SourishOP/Variable-rate-sprayer/report/figures/chart_spray_time.png

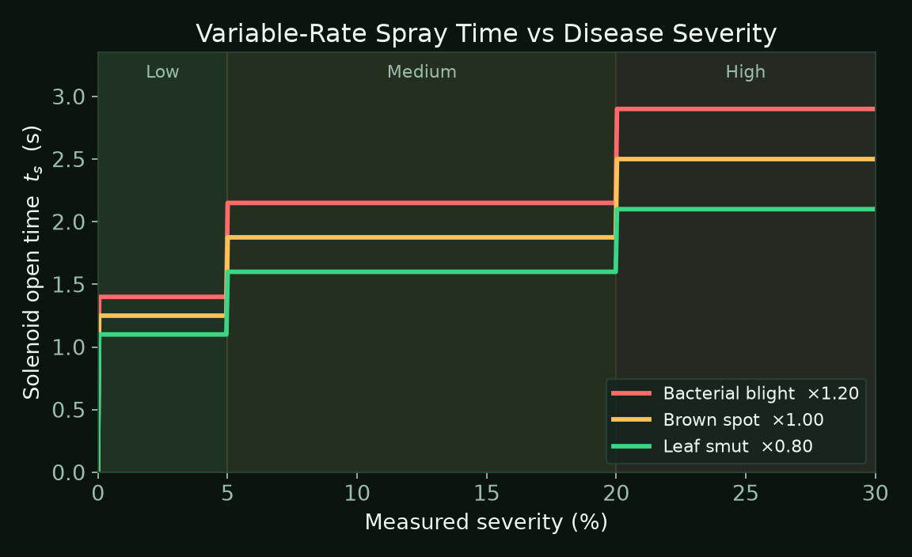
report/figures/chart_spray_time.png
