SourishOP/Variable-rate-sprayer/report/figures/fig_chemical_comparison.png

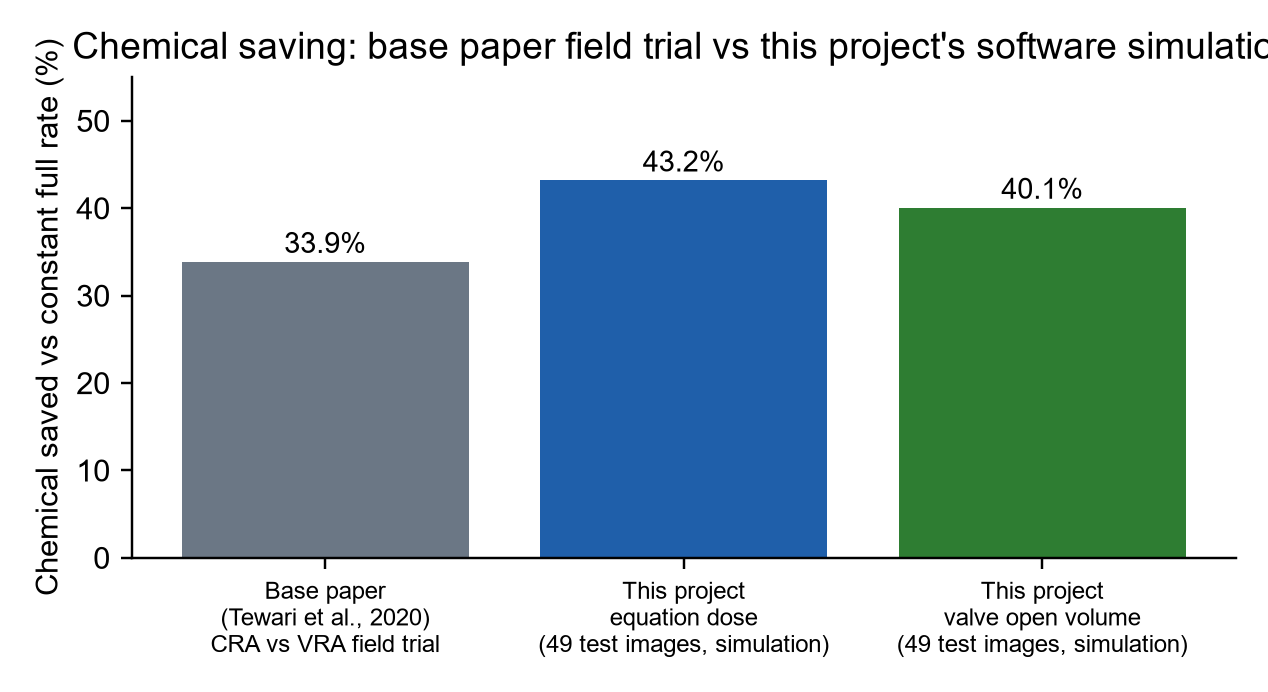
report/figures/fig_chemical_comparison.png
