SourishOP/Variable-rate-sprayer/report/figures/overlays/Bacterial_Blight__Bacterial_Blight_04.png

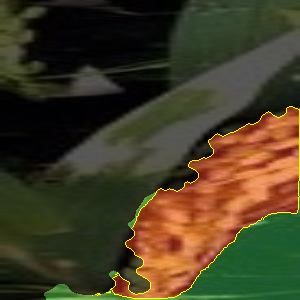
report/figures/overlays/Bacterial_Blight__Bacterial_Blight_04.png
