SourishOP/Variable-rate-sprayer/report/figures/overlays/Bacterial_Blight__Bacterial_Blight_07.png

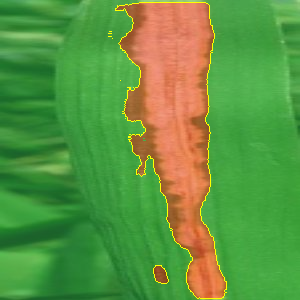
report/figures/overlays/Bacterial_Blight__Bacterial_Blight_07.png
