SourishOP/Variable-rate-sprayer/report/figures/overlays/Brown_Spot__Brown_Spot_06.png

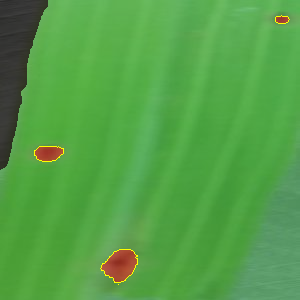
report/figures/overlays/Brown_Spot__Brown_Spot_06.png
