SourishOP/Variable-rate-sprayer/report/figures/overlays/Brown_Spot__Brown_Spot_08.png

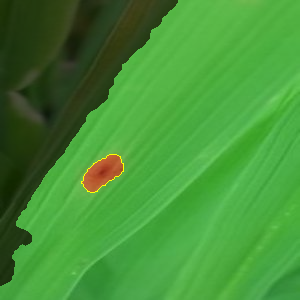
report/figures/overlays/Brown_Spot__Brown_Spot_08.png
