SourishOP/Variable-rate-sprayer/report/figures/overlays/healthy__healthy51.png

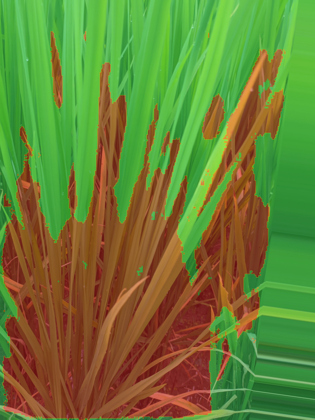
report/figures/overlays/healthy__healthy51.png
