SourishOP/Variable-rate-sprayer/report/figures/overlays/healthy__healthy440.png

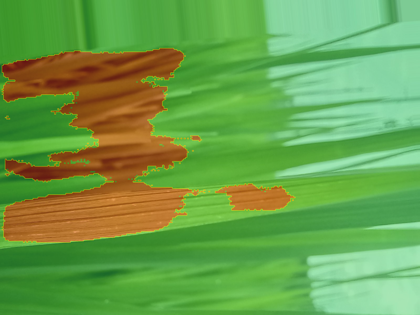
report/figures/overlays/healthy__healthy440.png
