SourishOP/Variable-rate-sprayer/report/figures/overlays/healthy__healthy456.png

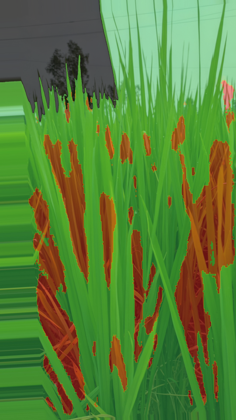
report/figures/overlays/healthy__healthy456.png
