SourishOP/Variable-rate-sprayer/report/figures/overlays/healthy__healthy462.png

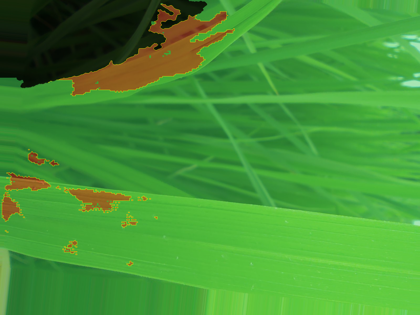
report/figures/overlays/healthy__healthy462.png
