SourishOP/Variable-rate-sprayer/report/figures/overlays/healthy__healthy467.png

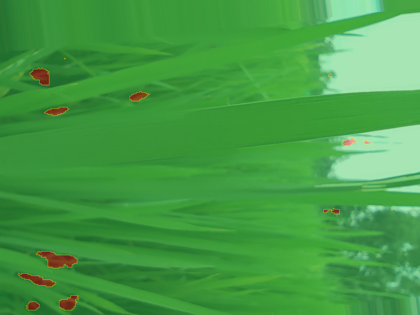
report/figures/overlays/healthy__healthy467.png
