SourishOP/Variable-rate-sprayer/report/figures/overlays/healthy__healthy514.png

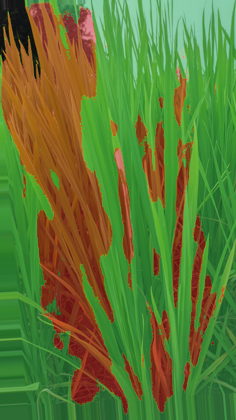
report/figures/overlays/healthy__healthy514.png
