SourishOP/Variable-rate-sprayer/report/figures/overlays/healthy__healthy516.png

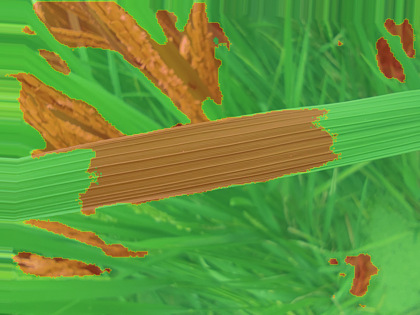
report/figures/overlays/healthy__healthy516.png
