SourishOP/Variable-rate-sprayer/report/figures/overlays/healthy__healthy549.png

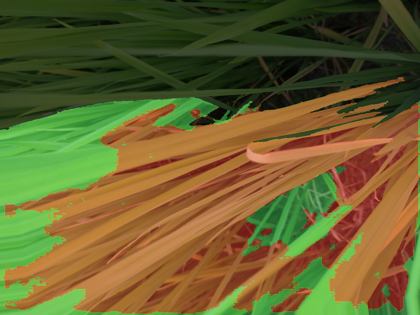
report/figures/overlays/healthy__healthy549.png
