SourishOP/Variable-rate-sprayer/report/figures/overlays/healthy__healthy554.png

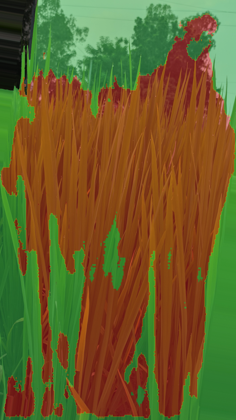
report/figures/overlays/healthy__healthy554.png
