SourishOP/Variable-rate-sprayer/report/figures/overlays/healthy__healthy558.png

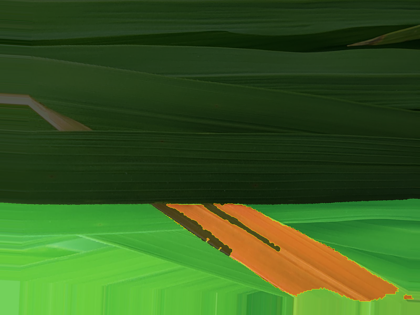
report/figures/overlays/healthy__healthy558.png
