SourishOP/Variable-rate-sprayer/report/figures/overlays/leaf_smut__BLAST8_080.png

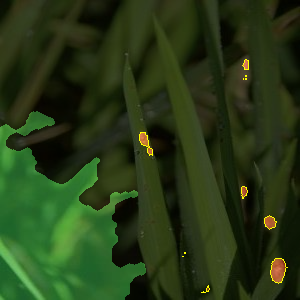
report/figures/overlays/leaf_smut__BLAST8_080.png
