SourishOP/Variable-rate-sprayer/report/figures/overlays/leaf_smut__BLAST8_154.png

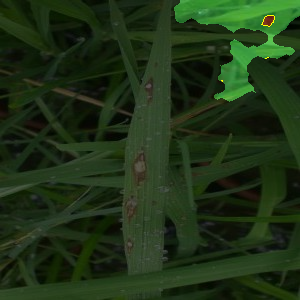
report/figures/overlays/leaf_smut__BLAST8_154.png
