SourishOP/Variable-rate-sprayer/report/figures/overlays/leaf_smut__BLAST9_002.png

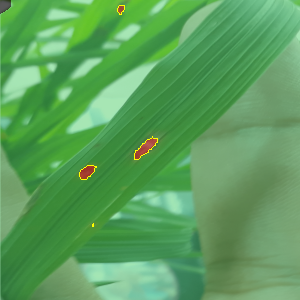
report/figures/overlays/leaf_smut__BLAST9_002.png
