SourishOP/Variable-rate-sprayer/report/figures/overlays/leaf_smut__BLAST9_003.png

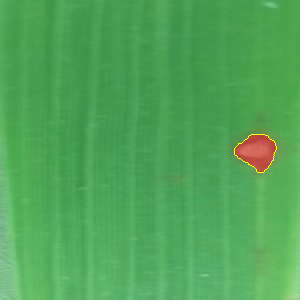
report/figures/overlays/leaf_smut__BLAST9_003.png
