SourishOP/Variable-rate-sprayer/report/figures/overlays/leaf_smut__BLAST9_011.png

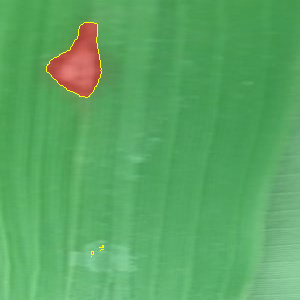
report/figures/overlays/leaf_smut__BLAST9_011.png
