SourishOP/Variable-rate-sprayer/report/figures/overlays/Neck_Blast__Neck_Blast_08.png

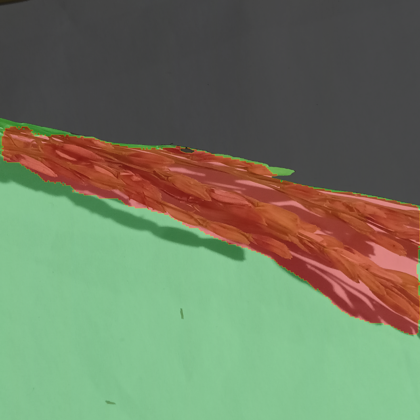
report/figures/overlays/Neck_Blast__Neck_Blast_08.png
