SourishOP/Variable-rate-sprayer/report/figures/ui_about.png

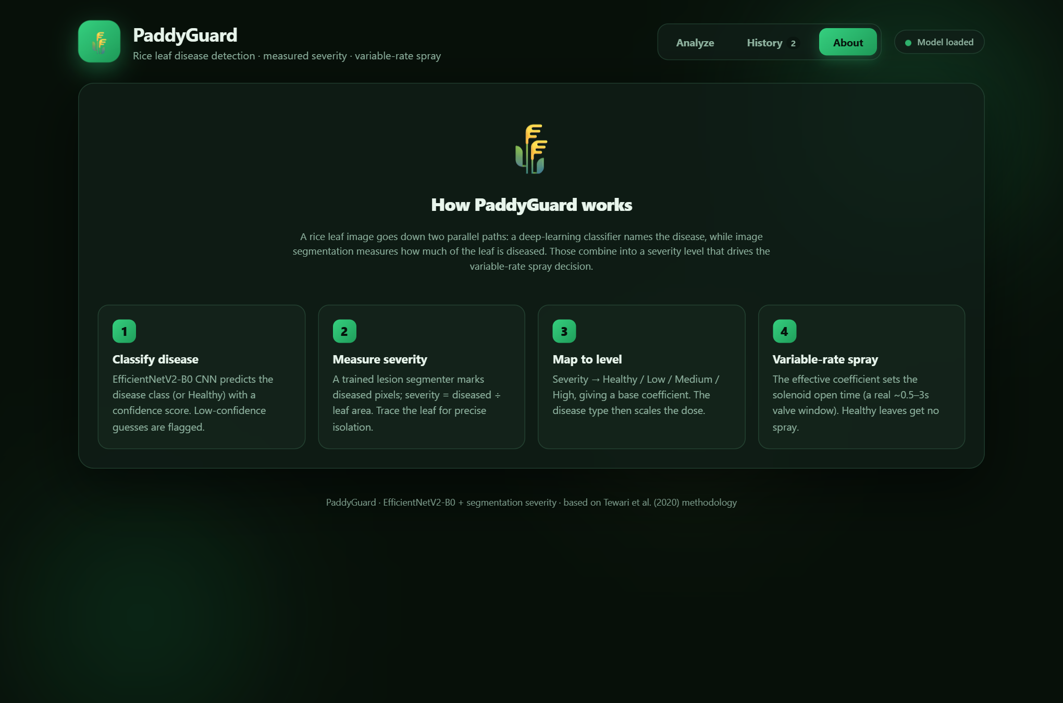
report/figures/ui_about.png
