SourishOP/Variable-rate-sprayer/results/BCSE497J_23BCE1179_23BCE1293_review2.pptx

## Deep Learning and IoT-Based Real-Time Variable-Rate Chemical Spraying System for Disease Control in Paddy Crop

Sourish Das (23BCE1179) & Aditya Singh (23BCE1293)
Guide – Dr. Vergin Raja Sarobin M.
BCSE497J - Project I | Fall Semester 2026-27
School of Computer Science and Engineering (SCOPE)
VIT Chennai

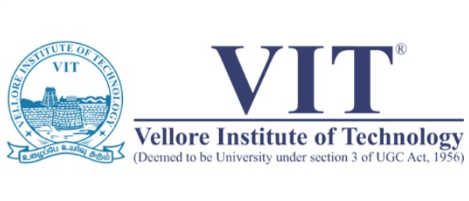
[picture p77: figure]

## Problem Statement

Context:
Plant diseases are not only a threat to food security at the global scale, but can also have disastrous consequences for smallholder farmers whose livelihoods depend on healthy crops.
The Problem with Conventional Spraying:
- The agrochemical application with conventional sprayers results in wastage of applied chemicals, which not only increases the economic losses but also pollutes the environment.
- The conventional sprayers apply the agrochemicals at a uniform rate, which leads to excessive, injudicious, and less effective utilization of applied chemicals. This uniform spraying results in wastage of applied chemicals and finally increases the cost of disease control.
- The extended amount of applied chemicals pollutes the environment and adversely affects the health of agricultural workers and food consumers. Besides, it also results in the development of heritable resistance in pests against pesticides.
Problem Statement:
Traditional agricultural irrigation lacks the capability to dynamically adjust water and treatment output based on localized plant disease severity. This leads to inefficient resource use, wasted water, and inadequate disease control. There is a need for an automated, smart sprinkler system that senses disease intensity on individual plants or zones and varies its fluid output accordingly to optimize treatment and conserve water.

## Domain: Variable-Rate Application (VRA)

VRA :
The intervention of advanced technologies such as sensors, microcontrollers, and software tools in agriculture, allow the precise use of the applied chemical by regulating the application rate according to the site-specific requirement. This method is called the variable-rate application (VRA), and it can significantly reduce the amount of applied chemicals and the cost of disease control.
Two Approaches:
- In the map-based approach, a preset site-specific map of desired properties is used to control the application rate.
- While, in the case of a sensor-based approach, the information of desired properties is collected on-the-go using sensors, and the application rate is regulated according to the processed information.
Sensor-Based for Disease Control :
- The map-based approach is not practically appropriate, as the diseases spread across the whole field very rapidly. Hence, the accuracy of sample data and the derived disease maps are time-sensitive, which means that the disease distribution may have changed by the time the map is prepared.
- The detection of crop disease and spraying should be performed in one single real-time working cycle, due to the fast-propagating nature of the pathogens. Therefore, the sensor-based variable-rate chemical application is preferred for disease control tasks.

## Domain: Deep Learning in Agriculture

Deep Learning:
More recently the Large Scale Visual Recognition Challenge (ILSVRC) based on the ImageNet dataset have been widely used as benchmarks for numerous visualization-related problems in computer vision, including object classification. In the following 3 years, various advances in deep convolutional neural networks (CNNs) lowered the error rate.
Advantage over Traditional Methods:
- The performance of these approaches thus depended heavily on the underlying predefined features. Feature engineering itself is a complex and tedious process which needs to be revisited every time the problem at hand or the associated dataset changes considerably.
- The image processing technique with the real-time machine vision system is one of the most commonly used on-the-go target detection methods for variable-rate spraying.
- Its high precision, quick response, and low input cost are made it more popular and widely acceptable in the area of agricultural automation.

## Literature Review: Variable-Rate Spraying Systems

# | Paper Name | Authors, Year | Methodology | Findings

1 | Image processing based real-time variable-rate chemical spraying system for disease control in paddy crop | Tewari et al., 2020 | Chromatic aberration (CA)-based image segmentation; laptop + MATLAB processing; Arduino controls solenoid valve based on 3 severity levels. | 33.88% minimum chemical reduction compared with CRA; validated in a 300 m² paddy field, lighting-sensitive CA thresholding; laptop-dependent; no IoT; minimum 33% spray; plant-spacing errors.
2 | Selective spraying of grapevines for disease control using a modular agricultural robot | Oberti et al., 2020 | Agricultural robot with machine-vision disease sensing and precision spot-spraying end-effector. | 65–85% pesticide reduction compared with conventional spraying, high cost; unsuitable for small farmers; grapevine-specific; complex mechanical setup.
3 | Development and evaluation of a low-cost and smart technology for precision weed management utilizing artificial intelligence | Partel et al., 2019 | Custom CNN for real-time weed detection integrated with nozzle actuation for site-specific herbicide application. | Low-cost smart sprayer with effective weed detection and significant herbicide reduction, weed-focused; limited to row crops; no IoT dashboard; no disease-severity-based dosage.
4 | Spot-application of fungicide for wild blueberry using an automated prototype variable rate sprayer | Esau et al., 2021 | Machine vision distinguishes foliage from bare spots; variable-rate spraying applied only to foliage. | Effective spot application with reduced fungicide usage, no disease-severity estimation; binary spray/no-spray decision; foliage rather than disease detection.
5 | Development of canopy vigour maps using UAV for site-specific management during vineyard spraying process | Campos et al., 2020 | UAV multispectral imaging; NDVI-based canopy-vigour maps used to adjust spraying rates. | 20–40% pesticide reduction through variable-rate spraying, expensive UAV and multispectral camera; not real-time; no disease detection.

## Literature Review: Deep Learning for Rice Disease Detection

# | Paper Name | Author, Year | Methodology | Findings

6 | Using Deep Learning for Image-Based Plant Disease Detection | Mohanty et al., 2021 | CNNs (AlexNet, GoogLeNet) trained on 54,306 PlantVillage images covering 14 crops and 26 diseases; transfer learning from ImageNet; color, grayscale, and segmented images tested. | 99.35% accuracy with GoogLeNet + transfer learning + color images; transfer learning consistently outperformed training from scratch, accuracy dropped to 31% on real-world field images; single leaves on homogeneous backgrounds; no hardware integration.
7 | Deep learning models for plant disease detection and diagnosis | Ferentinos, 2022 | VGGNet, ResNet, AlexNet, and GoogLeNet evaluated on 87,848 images covering 58 crop-disease classes across 25 plant species. | 99.53% accuracy using VGG; CNNs outperformed hand-engineered features for disease detection, controlled/lab conditions; VGG has 138M parameters, making it heavy for edge/API deployment; no field or sprayer integration.
8 | Deep feature based rice leaf disease identification using support vector machine | Sethy et al., 2020 | ResNet50 used as a deep feature extractor followed by an SVM classifier; tested on Brown Spot, Blast, and Bacterial Blight. | 98.38% accuracy; hybrid transfer learning + SVM outperformed end-to-end CNN for small rice disease datasets, lab images only; no real-time system; no sprayer integration; requires a separate SVM training pipeline.
9 | Identification and recognition of rice diseases and pests using convolutional neural networks | Rahman et al., 2020 | Custom CNN trained on 1,426 rice images covering 9 diseases and 3 pest categories; data augmentation used during training. | 95.83% overall accuracy for 12-class rice disease and pest classification, small dataset; no field validation; no hardware or sprayer integration; controlled image conditions.
10 | Paddy Doctor: A Visual Image Dataset for Automated Paddy Disease Classification | Petchiammal et al., 2022 | 10,407 labeled paddy leaf images covering 10 disease classes and healthy leaves; ResNet, EfficientNet, and MobileNet CNN baselines benchmarked. | Provides a comprehensive paddy-specific dataset; MobileNetV2 achieved competitive accuracy with significantly lower computational cost, dataset/benchmark only; no real-time system or hardware prototype; no VRA sprayer integration.
11 | Using deep transfer learning for image-based plant disease identification | Chen et al., 2020 | InceptionV3 with ImageNet transfer learning; domain adaptation used to reduce the gap between laboratory and field images. | Improved real-world accuracy through domain adaptation; confirmed the importance of transfer learning for small agricultural datasets, significant accuracy drop remains in uncontrolled field conditions; no integrated hardware; no real-time operation.

## Slide 7

Literature Review: IoT in Precision Agriculture & Integrated Systems

# | Paper Name | Author, Year | Methodology | Findings

12 | Development of a variable rate chemical sprayer for monitoring diseases and pests infestation in coconut plantations | Samseemoung et al., 2017 | Image-processing algorithm estimates disease density and determines the corresponding chemical amount; wireless remote monitoring system integrated. | Variable-rate spraying with remote monitoring demonstrated for coconut; reduced chemical wastage through density-based spraying, traditional image processing, not deep learning; coconut-specific; limited scalability; complex system setup.
13 | IoT-based precision agriculture: A review of smart spraying systems for pest and disease control | Materne & Ilunga, 2022 | Comprehensive review of IoT-integrated smart spraying systems, including ESP32, Raspberry Pi, drone-based, and sensor-based approaches. | Identifies the growing trend toward DL + IoT integration; maps the state of the art and highlights ESP32 as a viable low-cost platform, review paper only; no implementation; identifies that DL + IoT + VRA integration remains largely unexplored.
14 | Development and field evaluation of a machine vision based in-season weed detection system for wild blueberry | Rehman et al., 2019 | Machine vision using color and texture features for weed detection; real-time processing pipeline; evaluated throughout the full growing season. | Field-validated weed detection across a full season; demonstrated robustness under agricultural field conditions, weed-focused only, not disease detection; traditional features rather than deep learning; no variable-rate actuation.
15 | A real-time weed mapping and precision herbicide spraying system for row crops | Xu et al., 2018 | Multi-sensor camera system for real-time weed mapping; precision nozzle control using solenoid valves for site-specific herbicide application. | Demonstrated real-time mapping and precision spraying with significant herbicide reduction in row-crop fields, weed control only; no disease-severity estimation; no IoT dashboard; no deep learning; custom hardware is not low-cost.

## Literature Review — CNN Architectures Evaluated

From Mohanty et al. (2022):
- We focus on two popular architectures, namely AlexNet and GoogLeNet, which were designed in the context of the "Large Scale Visual Recognition Challenge" (ILSVRC) for the ImageNet dataset.
- The GoogleNet architecture is a much deeper and wider architecture with 22 layers, while still having considerably lower number of parameters (5 million parameters) in the network than AlexNet (60 million parameters).
- The key difference between these two learning approaches (transfer vs. training from scratch) is in the initial state of weights of a few layers, which lets the transfer learning approach exploit the large amount of visual knowledge already learned by the pre-trained AlexNet and GoogleNet models extracted from ImageNet.
Our Choice — MobileNetV2:
- Lightweight (3.4M params)
- Designed for mobile/edge
- Transfer learning from ImageNet
- Better suited for real-time cloud inference than heavy GoogLeNet.

## Identified Research Gap & Our Contribution

Gap in Existing Work | Our Contribution
Base paper uses simple CA thresholding — sensitive to lighting, limited generalization | CNN-based deep learning model (MobileNetV2 with transfer learning) for robust multi-disease classification
Base paper requires laptop + MATLAB — bulky, expensive | ESP32-CAM + Cloud inference — compact, <₹2500 total
No remote monitoring capability | Blynk IoT dashboard for real-time disease tracking
Only 3 severity levels (always sprays at minimum 33%) | 4 levels: Healthy (0% spray) + Low + Medium + High — eliminates waste on healthy plants
This problem occurs in all traditional attempts to detect plant diseases using computer vision as they lean heavily on hand-engineered features, image enhancement techniques, and a host of other complex and labor-intensive methodologies. | End-to-end deep learning eliminates manual feature engineering

## Project Objectives

1. Develop a CNN-based deep learning model (MobileNetV2) for real-time classification and severity estimation of paddy plant diseases.
2. Design and develop a low-cost (<Rs.2500) variable-rate spraying system using ESP32-CAM and Arduino Nano for precise agrochemical application.
3. Integrate IoT-based remote monitoring (Blynk) for real-time disease distribution tracking and chemical usage logging.
4. Evaluate system performance by comparing VRA vs CRA and quantifying chemical savings.

## Scope & Expected Outcomes

Scope:
- Target crop: Paddy/Rice (Bacterial Blight, Brown Spot, Leaf Smut, Healthy).
- Single-row prototype with cloud inference (Google Colab + Flask + ngrok).
- 4-level severity categorization with reduction coefficients.
- Budget: Under Rs.2500.
Expected Outcomes:
- CNN accuracy: >90% (approx.) on test set.
- Chemical saving: >= 33% (approx.).
- Real-time Blynk dashboard: severity gauge, usage logs, alerts.
- Working hardware prototype with end-to-end demonstration.
- Response time: <5 seconds (approx.) per spray cycle.

## Proposed Methodology - Overview

Operational Flow (same core methodology as base paper with CNN upgrade):
I. Initially, the web camera captures the paddy plant image and stores it in the laptop, where the lesion region of plant leaves is identified.
II. The processed output in terms of disease severity is determined using the developed image processing algorithm. The category of plant disease severity is decided according to threshold limits, and this information is then sent to the Arduino microcontroller. The microcontroller assigns the reduction coefficient of the recommended application rate according to the category of disease severity.
III. Further, it computes the required amount of chemical to be sprayed and the opening time duration for each solenoid valve to supply that amount using Eqs. (1) and (2).
IV. After this, the microcontroller then sends a 5 VDC signal to the respective relay switch, which further actuates the associated 12 VDC solenoid valve, and the required amount of input chemical is sprayed on the diseased paddy plants.
Our Modification:
Replace webcam+laptop+CA thresholding → ESP32-CAM + Cloud CNN (MobileNetV2) + Blynk IoT

## Proposed Methodology: CNN Model Pipeline

Model: MobileNetV2 (Transfer Learning from ImageNet):
- Input: 224×224 RGB paddy leaf image
- Architecture: Inverted residual blocks, depthwise separable convolutions
- Training: Google Colab GPU, ~20 epochs, Adam optimizer
- Dataset: Rice Leaf Disease (Kaggle) — 4 classes
- Data Augmentation: Random rotation, horizontal flip, brightness/contrast variation
- Output: Softmax probabilities across 4 classes → Severity mapping
MobileNetV2 over AlexNet/GoogLeNet:
- Among the AlexNet and GoogLeNet architectures, GoogLeNet consistently performs better than AlexNet, and based on the method of training, transfer learning always yields better results, both of which are expected.
- MobileNetV2 is even more lightweight (3.4M params vs 5M for GoogLeNet vs 60M for AlexNet)
- Optimized for mobile/edge inference — faster API response
- Transfer learning from ImageNet proven to work for plant diseases

## Proposed Methodology: Spray Decision Algorithm

Our 4-Level Severity (improved from base paper's 3 levels):

Category | Disease Severity (S) | Reduction Coeff. (C) | Spray Action
Healthy (Novel) | 0% (CNN: healthy class) | 0.00 | NO SPRAY
Low (I) | 0 - 5% | 0.33 | Light spray (33% of recommended)
Medium (II) | 5 - 20% | 0.67 | Medium spray (67% of recommended)
High (III) | 20 - 100% | 1.00 | Full spray (100% of recommended)

Equations (from base paper):
a = (C x A) / (d x 10)….. (1), where a = chemical per hill (mL), A = recommended rate (L/ha), d = hill density (hills/m2)
ts = a / Qs ….. (2), where ts = solenoid open time (s), Qs = flow rate (mL/s)
Base paper: 33% of the recommended application rate was selected as the base rate and assigned for the low (0–5%) plant disease severity level. The other two chemical dosages, i.e., 67% and 100% of the recommended application rate, were assigned for the medium (5–20%) and high (20–100%) plant disease severity levels, respectively.
Our improvement: Adding Healthy (C=0.00) means zero chemical on healthy plants — saves even more than 33% (approx).

## Slide 15

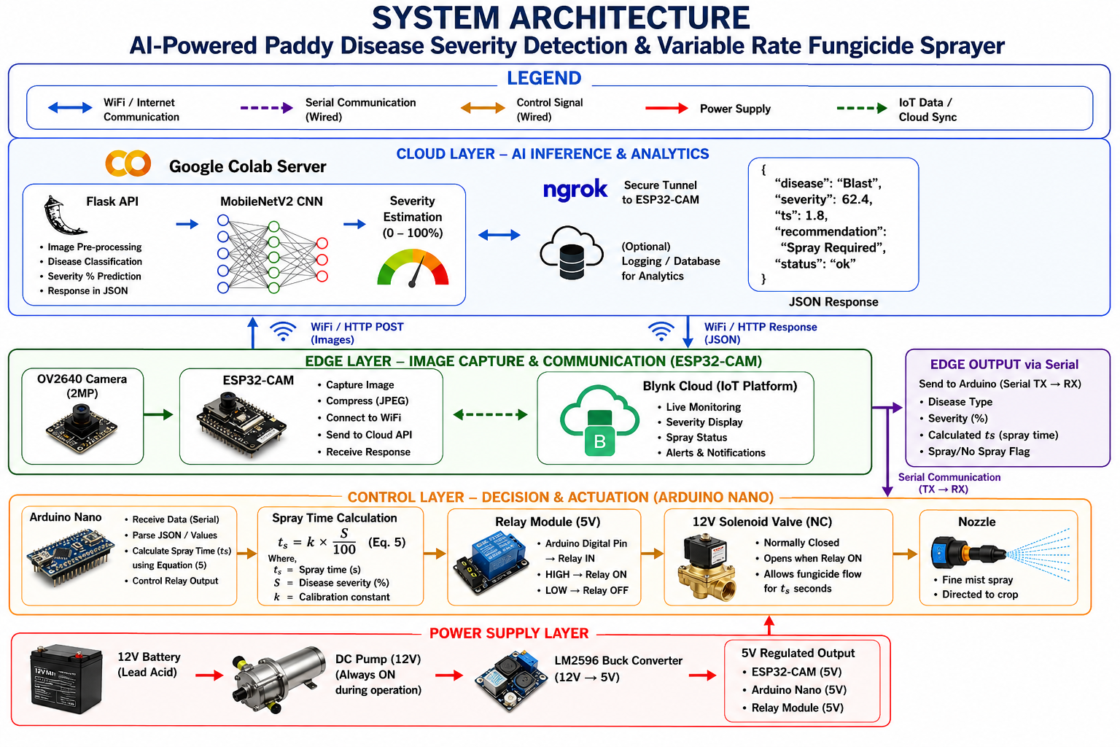
[picture p78: figure]

## Module Design

Module | Component | Function
Image Acquisition | ESP32-CAM (OV2640, 640x480) | Captures paddy leaf image on trigger
Communication | ESP32 WiFi (802.11 b/g/n) | HTTP POST to cloud; receives JSON result
Cloud Processing | Colab (MobileNetV2 + Flask + ngrok) | CNN inference; returns severity class
IoT Monitoring | Blynk (Virtual Pins V0-V5) | Dashboard: gauge, logs, alerts, remote trigger
Control Logic | Arduino Nano (ATmega328P) | Computes spray duration ts; controls relay
Actuation | 5V Relay + 12V Solenoid (NC) | Opens valve for computed duration
Spray Delivery | R385 Pump + Hollow Cone Nozzle | Maintains flow; delivers spray pattern
Power | 3x18650 + LM2596 Buck | 12V source + regulated 5V for MCUs

## Hardware Components

# | Component | Model/Specs

1 | ESP32-CAM | AI-Thinker, OV2640, WiFi+BT, 4MB PSRAM
2 | ESP32-CAM Programmer | ESP32-CAM-MB, CH340 USB
3 | Arduino Nano | V3.0, ATmega328P, CH340
4 | Solenoid Valve | 12V DC, NC, 1/2 inch, Plastic
5 | Relay Module | 5V 1-Ch, Optocoupler, Songle SRD-05VDC
6 | Water Pump | R385, 12V DC, Diaphragm, 1.5 L/min
7 | Battery + Holder | 3x 18650 Li-ion (3.7V, 2600mAh) + Holder
8 | Buck Converter | LM2596, Adjustable, 12V to 5V
9 | Spray Nozzle | Brass, Hollow Cone, 1/4 inch
10 | Miscellaneous | Silicone tubing, jumper wires, button, breadboard

Software Tools & Technologies

Layer | Technology | Purpose
CNN Training | Python 3.x, TensorFlow/Keras, Google Colab (T4 GPU) | Model development and training
Model Architecture | MobileNetV2 (ImageNet pretrained) | Lightweight CNN for disease classification
Inference API | Flask + pyngrok | REST endpoint for image classification
ESP32-CAM Firmware | Arduino IDE, ESP32 Board Package, HTTPClient | Camera control, WiFi comm, serial output
Arduino Firmware | Arduino IDE, SoftwareSerial | Valve timing control logic
IoT Dashboard | Blynk IoT (Free Tier), Blynk Library | Remote monitoring and alerts
Dataset | Kaggle Rice Leaf Disease Dataset | 4-class labeled paddy leaf images

## Feasibility Analysis

Factor | Assessment
Technical | ESP32-CAM proven WiFi+camera; MobileNetV2 achieves >95% on plant diseases; Arduino + relay well-established for valve control
Economic | Total Rs.2375 - affordable for students and small farmers; all software free (Colab, Blynk, Arduino IDE)
Time | 14 weeks: CNN (2wk) + API (1wk) + Firmware (3wk) + Hardware (2wk) + Integration (3wk) + Testing (2wk) + Report (1wk)
Data | Kaggle Rice Leaf Disease dataset - publicly available, labeled, sufficient for transfer learning
Infrastructure | VIT WiFi/Mobile hotspot for testing; Google Colab free GPU; Components available on Amazon India

Risk Analysis & Mitigation

Risk | Impact | Mitigation Strategy
Colab session timeout | API becomes unavailable | Auto-restart script; backup: local Flask on laptop
No WiFi in field | Cannot send image for inference | Mobile hotspot; future scope: TFLite on-device
Low CNN accuracy on real images | Incorrect spray decisions | Data augmentation; fine-tune with ESP32-CAM captured images
Field lighting variation | Poor image quality | Green cloth covering (same approach as base paper)
Solenoid timing errors | Over/under spraying | Precise Qs calibration; camera placed ahead of nozzle
Component failure | System downtime | Keep spare ESP32-CAM and relay (Rs.600 backup)

## Ethical Considerations

- Environmental: Reduces chemical pollution — The developed system appears promising and could be used extensively to reduce the cost of pest management as well as to control environmental pollution due to such agrochemicals.
- Health & Safety: Less chemical exposure for agricultural workers and food consumers
- Economic Equity: Under ₹2500 cost makes precision agriculture accessible to smallholder farmers
- Data Ethics: Using publicly available Kaggle dataset with proper citations
- Code Ethics: Open-source libraries, no proprietary lock-in
- AI Acknowledgment: Plagiarism, unauthorized copying and undisclosed AI-generated content are not permitted. Any significant use of AI tools shall be appropriately acknowledged. — All AI tool usage will be disclosed

## Work Plan & Timeline

Week | Task | Owner | Deliverable
1-2 (Jul) | Literature review, problem definition, Review 1 | Both | Report Ch.1-2
3-4 (Jul) | CNN model training & validation | Sourish Das | Trained model (>90%)
5-6 (Aug) | Flask API + ngrok; Review 2 preparation | Sourish Das | Working cloud API
7-8 (Aug-Sep) | ESP32-CAM firmware (image capture + HTTP) | Aditya Singh | ESP32 sends & receives
9-10 (Sep) | Arduino code + hardware assembly; Review 3 | Aditya Singh | Valve control working
11-12 (Oct) | Blynk IoT + field testing + VRA vs CRA comparison | Both | End-to-end prototype
13 (Oct) | Results analysis, report; Review 4 | Both | Complete report + demo
14 (Oct) | Final demo + viva; Review 5 | Both | Final presentation

Member Responsibilities:

Member | Primary Responsibilities
Sourish Das | CNN model development, Flask API development, cloud deployment, and Blynk IoT coding
Aditya Singh | ESP32-CAM firmware development, Arduino Nano control logic, hardware assembly, circuit wiring, and system testing

## Novelty: Base Paper vs Our Proposed System

Aspect | Tewari et al. (2020) - Base Paper | Our Proposed System
Disease Detection | Chromatic Aberration (CA) thresholding | CNN (MobileNetV2) deep learning
Compute Platform | Laptop (Intel i5 + MATLAB R2014b) | ESP32-CAM + Cloud (Google Colab)
Image Processing | MATLAB Image Processing Toolbox | Python + TensorFlow/Keras (free)
Monitoring | None | Blynk IoT dashboard (mobile app)
Severity Levels | 3 levels (always sprays min 33%) | 4 levels (Healthy = 0% spray)
Estimated Cost | High (Laptop + webcam + MATLAB license) | Under Rs.2500
Portability | Cart with laptop mounted | Compact embedded system
Robustness | Sensitive to lighting changes | CNN generalizes across conditions

## References

[1] Tewari, V.K., Pareek, C.M., Lal, G., Dhruw, L.K., & Singh, N. (2020). Image processing based real-time variable-rate chemical spraying system for disease control in paddy crop. Artificial Intelligence in Agriculture, 4, 21-30. https:// (https://doi.org/10.1016/j.aiia.2020.01.002)doi.org/10.1016/j.aiia.2020.01.002
[2] Mohanty, S.P., Hughes, D.P., & Salathé, M. (2016). Using Deep Learning for Image-Based Plant Disease Detection. Frontiers in Plant Science, 7, 1419. https:// (https://doi.org/10.3389/fpls.2016.01419)doi.org/10.3389/fpls.2016.01419
[3] Oberti, R., Marchi, M., Tirelli, P., et al. (2016). Selective spraying of grapevines for disease control using a modular agricultural robot. Biosystems Engineering, 146, 203-215. https:// (https://doi.org/10.1016/j.biosystemseng.2015.12.004)doi.org/10.1016/j.biosystemseng.2015.12.004
[4] Partel, V., Kakarla, S.C., & Ampatzidis, Y. (2019). Development and evaluation of a low-cost and smart technology for precision weed management utilizing artificial intelligence. Computers and Electronics in Agriculture, 157, 339-350. https:// (https://doi.org/10.1016/j.compag.2018.12.048)doi.org/10.1016/j.compag.2018.12.048
[5] Esau, T.J., Zaman, Q.U., Chang, Y.K., et al. (2014). Spot-application of fungicide for wild blueberry using an automated prototype variable rate sprayer. Precision Agriculture, 15(2), 147-161. https:// (https://doi.org/10.1007/s11119-013-9319-4)doi.org/10.1007/s11119-013-9319-4
[6] Campos, J., Llop, J., Gallart, M., et al. (2020). Development of canopy vigour maps using UAV for site-specific management during vineyard spraying process. Precision Agriculture, 21, 1136-1156. https:// (https://doi.org/10.1007/s11119-019-09694-2)doi.org/10.1007/s11119-019-09694-2
[7] Ferentinos, K.P. (2018). Deep learning models for plant disease detection and diagnosis. Computers and Electronics in Agriculture, 145, 311-318. https:// (https://doi.org/10.1016/j.compag.2017.11.017)doi.org/10.1016/j.compag.2017.11.017
[8] Sethy, P.K., Barpanda, N.K., Rath, A.K., & Behera, S.K. (2020). Deep feature based rice leaf disease identification using support vector machine. Computers and Electronics in Agriculture, 175, 105527. https (https://doi.org/10.1016/j.compag.2020.105527):// (https://doi.org/10.1016/j.compag.2020.105527)doi.org/10.1016/j.compag.2020.105527

## References

[9] Rahman, C.R., Arko, P.S., Ali, M.E., et al. (2020). Identification and recognition of rice diseases and pests using convolutional neural networks. Biosystems Engineering, 194, 112-120. https://doi.org/10.1016/j.biosystemseng.2020.03.020
[10] Chen, J., Chen, J., Zhang, D., Sun, Y., & Nanehkaran, Y.A. (2020). Using deep transfer learning for image-based plant disease identification. Computers and Electronics in Agriculture, 173, 105393. https:// (https://doi.org/10.1016/j.compag.2020.105393)doi.org/10.1016/j.compag.2020.105393
[11] Samseemoung, G., Soni, P., & Suwan, P. (2017). Development of a variable rate chemical sprayer for monitoring diseases and pests infestation in coconut plantations. Agriculture, 7(10), 89. https:// (https://doi.org/10.3390/agriculture7100089)doi.org/10.3390/agriculture7100089
[12] Rehman, T.U., Zaman, Q.U., Chang, Y.K., et al. (2019). Development and field evaluation of a machine vision based in-season weed detection system for wild blueberry. Computers and Electronics in Agriculture, 162, 1-13. https://doi.org/10.1016/j.compag.2019.03.023
[13] Xu, Y., Gao, Z., Khot, L., Meng, X., & Zhang, Q. (2018). A real-time weed mapping and precision herbicide spraying system for row crops. Sensors, 18(12), 4245. https:// (https://doi.org/10.3390/s18124245)doi.org/10.3390/s18124245
[14] J. Zhang, Y. Chen, C. Gu, Z. Li, J. Huang, X. Lv, S. Zhang, and W. Qiu, “A variable-rate spraying method fusing canopy volume and disease detection to reduce pesticide dosage,” Computers and Electronics in Agriculture, vol. 237, p. 110606, 2025, doi: 10.1016/j.compag.2025.110606.
[15] A. E. Abioye, P. A. Larbi, and A. A. K. Hadwan, “Deep learning guided variable rate robotic sprayer prototype,” Smart Agricultural Technology, vol. 9, p. 100540, 2024, https (https://doi.org/10.1016/j.atech.2024.100540)://doi.org/10.1016/j.atech.2024.100540.

## Thank you for your time. We're happy to take questions.
