SourishOP/Variable-rate-sprayer/results/README.md

# results

| File | Contents |
|---|---|
| `RESULTS.md` | Classifier and segmenter metrics, severity to spray mapping, how each metric is computed, limitations |
| `confusion_matrix.png` | Confusion matrix of the deployed classifier (validation run, 748 of 859 correct) |
| `confusion_matrix_merged.png` | Confusion matrix of the merged 6-class classifier (815 validation images) |
| `chart_train_val_accuracy.png` | Training and validation accuracy |
| `chart_spray_time.png` | Spray time against severity |
| `BCSE497J_23BCE1179_23BCE1293_review2.pptx` | Review II presentation |
| `BCE497J_23BCE1179_23BCE1293_review3.pptx` | Review III presentation |

The charts are generated by [../scripts/make_charts.py](../scripts/README.md).

Back to the [main README](../README.md).
