SourishOP/Variable-rate-sprayer/(commit log)

2026-10-29 feat(app): accept raw RGB565 frames from ESP32-CAM and log requests
2026-10-29 chore: restructure repository, add section READMEs, mask credentials
    - move notebooks, firmware, hardware docs, sample images and report sources into a clean layout
    - rewrite root README and add a README per section folder
    - load Wi-Fi/Blynk values from git-ignored secrets.h (secrets.h.example committed)
    - remove Kaggle token from main_model.ipynb
    - fix stale training instructions and paths after the move
    - extend .gitignore, add MIT LICENSE
    [cam_capture_test.ino, cam_probe.ino, esp32cam_sprayer.ino, valve_controller.ino]
2026-10-29 docs: add instructions for running the backend with real ESP32-CAM images
